pu2clr/SI4825_UPGRADE/Imagens/box_modification_01.jpg

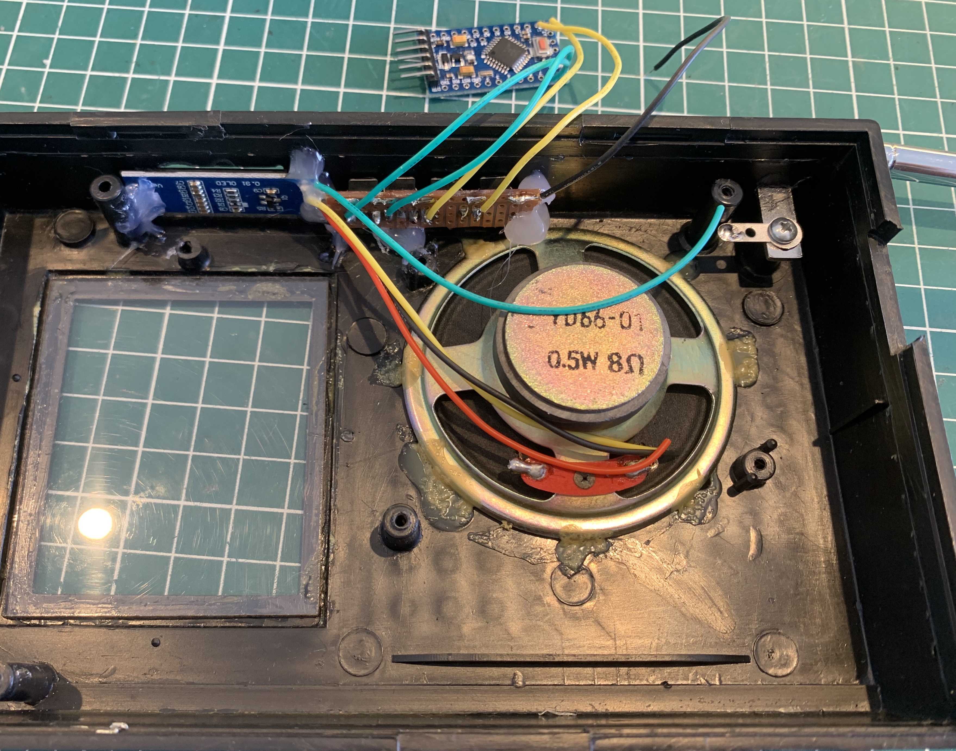
Imagens/box_modification_01.jpg
