pu2clr/SI4825_UPGRADE/Imagens/original_receiver.jpg

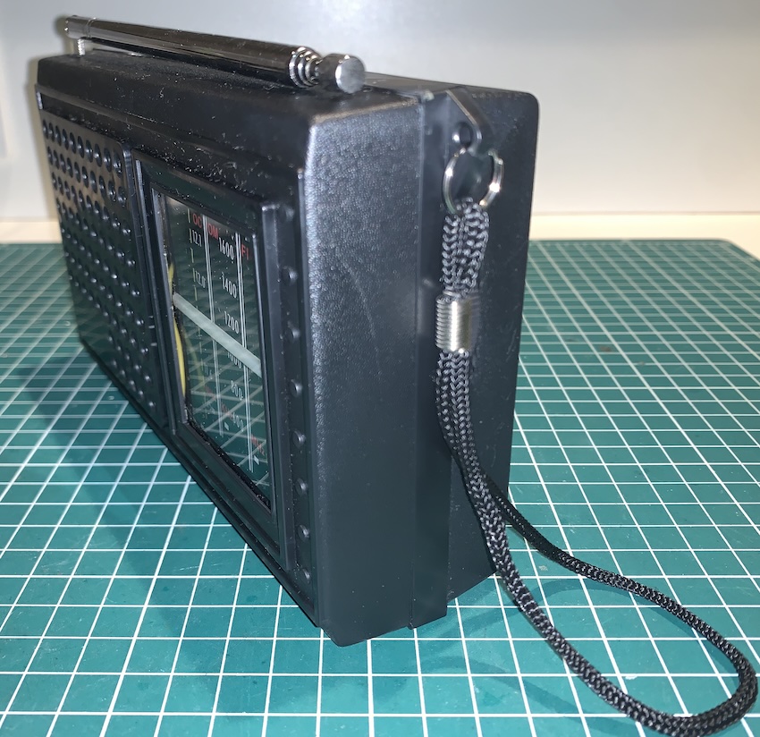
Imagens/original_receiver.jpg
