pu2clr/SI4825_UPGRADE/Imagens/removing_si4825.jpg

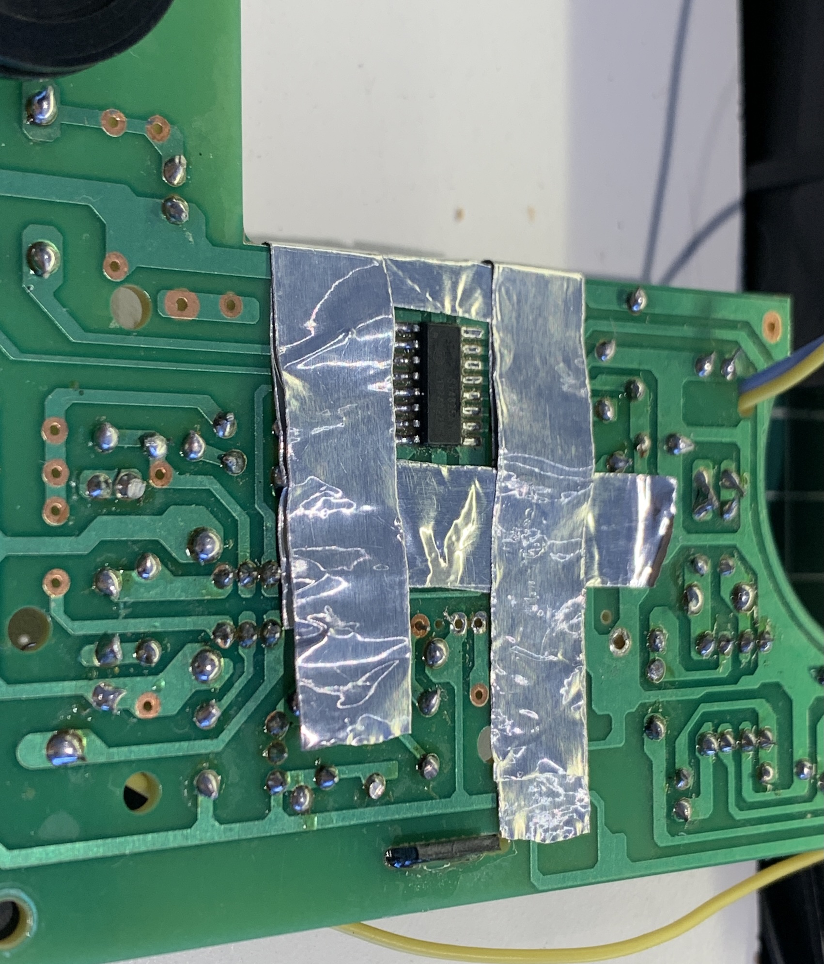
Imagens/removing_si4825.jpg
