pu2clr/SI4825_UPGRADE/Imagens/si4825_iub_CI_02.jpg

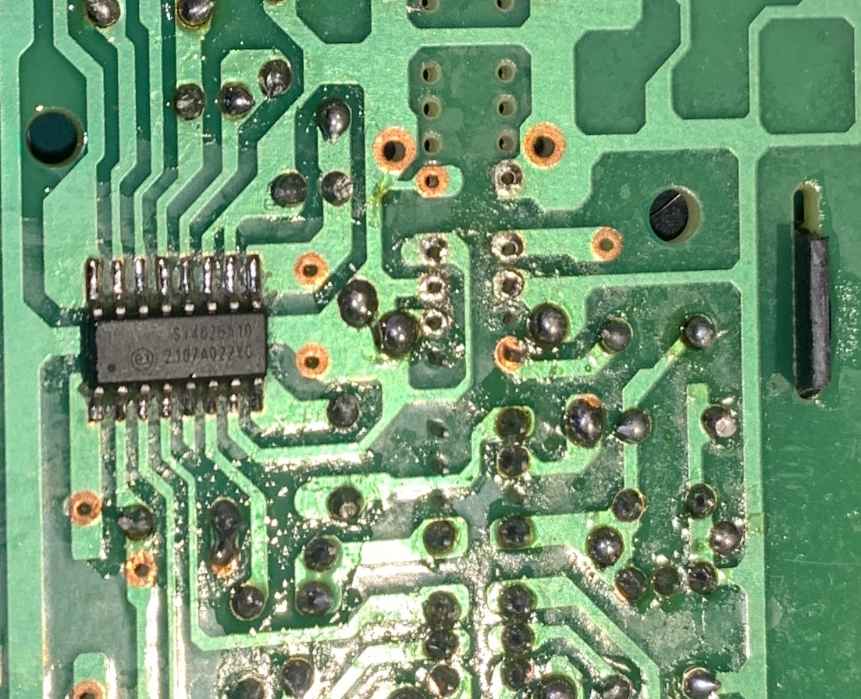
Imagens/si4825_iub_CI_02.jpg
