pu2clr/SI4825_UPGRADE/Imagens/tmp_01.jpg

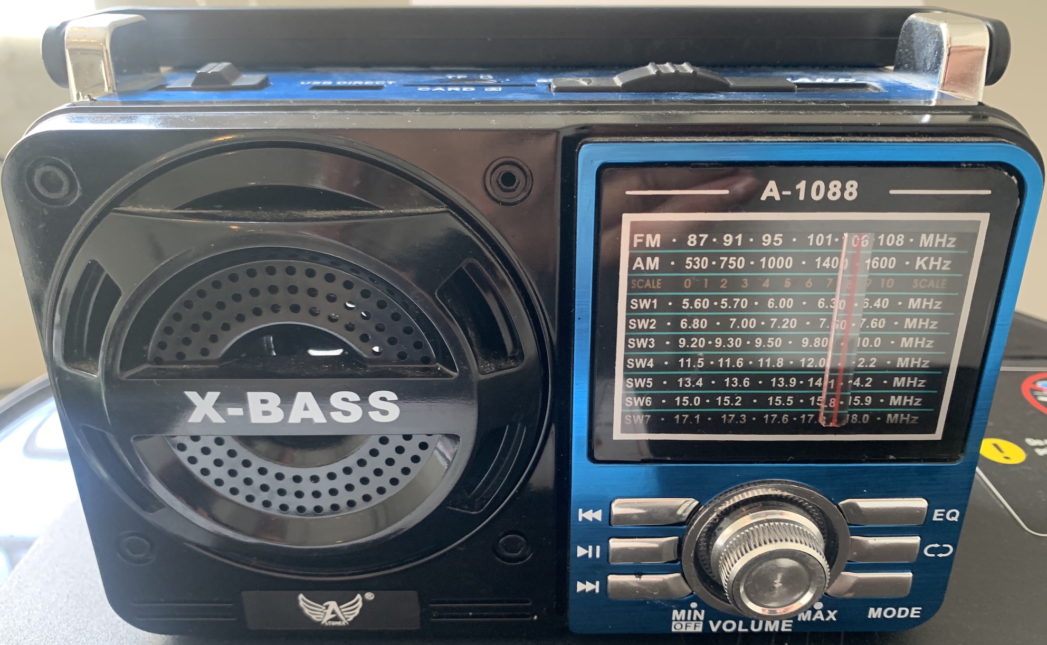
Imagens/tmp_01.jpg
