pu2clr/SI4825_UPGRADE/Arduino/SI4827_BASIC_SETUP/si4827.kicad_sch

## KiCad design Arduino/SI4827_BASIC_SETUP/si4827.kicad_sch (2024-12-15)

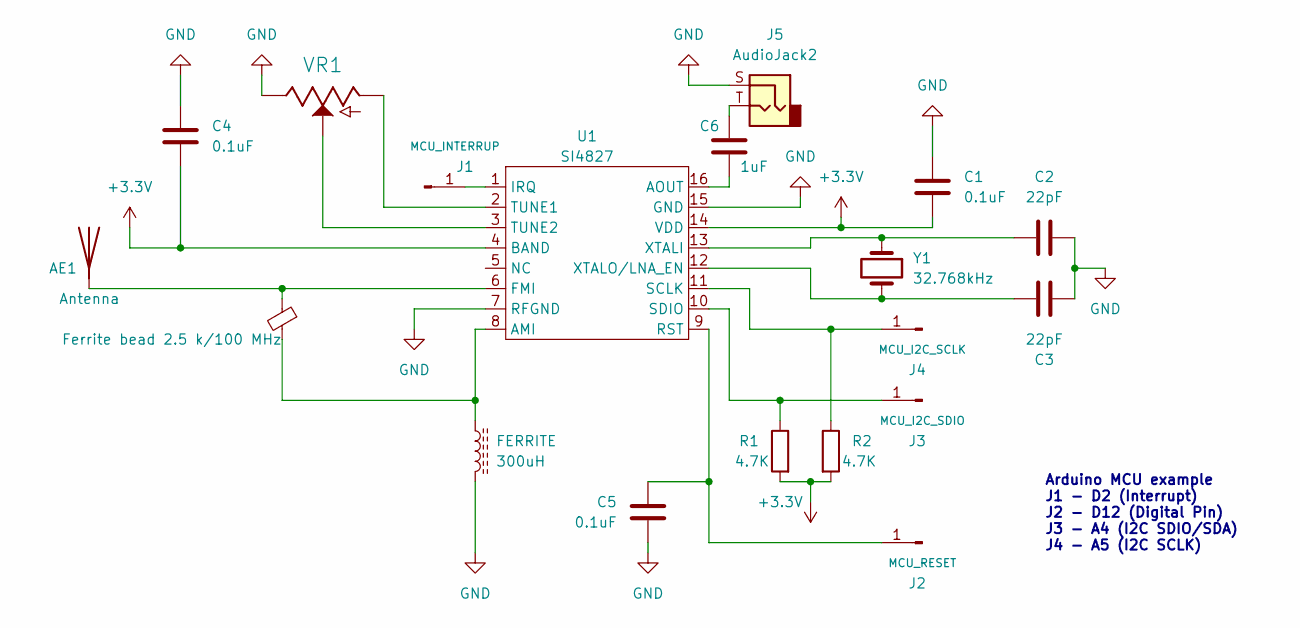
[picture p19: schematic si4827.kicad_sch]

Parts:
AE1: Antenna
C1, C4, C5: 0.1uF
C2, C3: 22pF
C6: 1uF
FB1: Ferrite bead 2.5 k/100 MHz
FERRITE: 300uH
J1: MCU_INTERRUP
J2: MCU_RESET
J3: MCU_I2C_SDIO
J4: MCU_I2C_SCLK
J5: AudioJack2
R1, R2: 4.7K
U1: SI4827
VR1: POT-PTH-ALPS
Y1: 32.768kHz

Connections:
+3.3V: C1.2, C4.2, R1.2, R2.2, U1.4 (BAND), U1.14 (VDD)
GND: C1.1, C2.1, C3.1, C4.1, C5.2, FERRITE.2, J5.S, U1.7 (RFGND), U1.15 (GND), VR1.P$1 (E)
unnamed: AE1.1, FB1.1, U1.6 (FMI)
unnamed: C2.2, U1.13 (XTALI), Y1.1
unnamed: C3.2, U1.12 (XTALO/LNA_EN), Y1.2
unnamed: C5.1, J2.1, U1.9 (RST)
unnamed: C6.1, J5.T
unnamed: C6.2, U1.16 (AOUT)
unnamed: FB1.2, FERRITE.1, U1.8 (AMI)
unnamed: J1.1, U1.1 (IRQ)
unnamed: J3.1, R1.1, U1.10 (SDIO)
unnamed: J4.1, R2.1, U1.11 (SCLK)
unnamed: U1.2 (TUNE1), VR1.P$3 (A)
unnamed: U1.3 (TUNE2), VR1.P$2 (S)

Notes on the sheet:
Arduino MCU example J1 - D2 (Interrupt) J2 - D12 (Digital Pin) J3 - A4 (I2C SDIO/SDA) J4 - A5 (I2C SCLK)
